mfikes/esprit-board/esprit-board.PDF

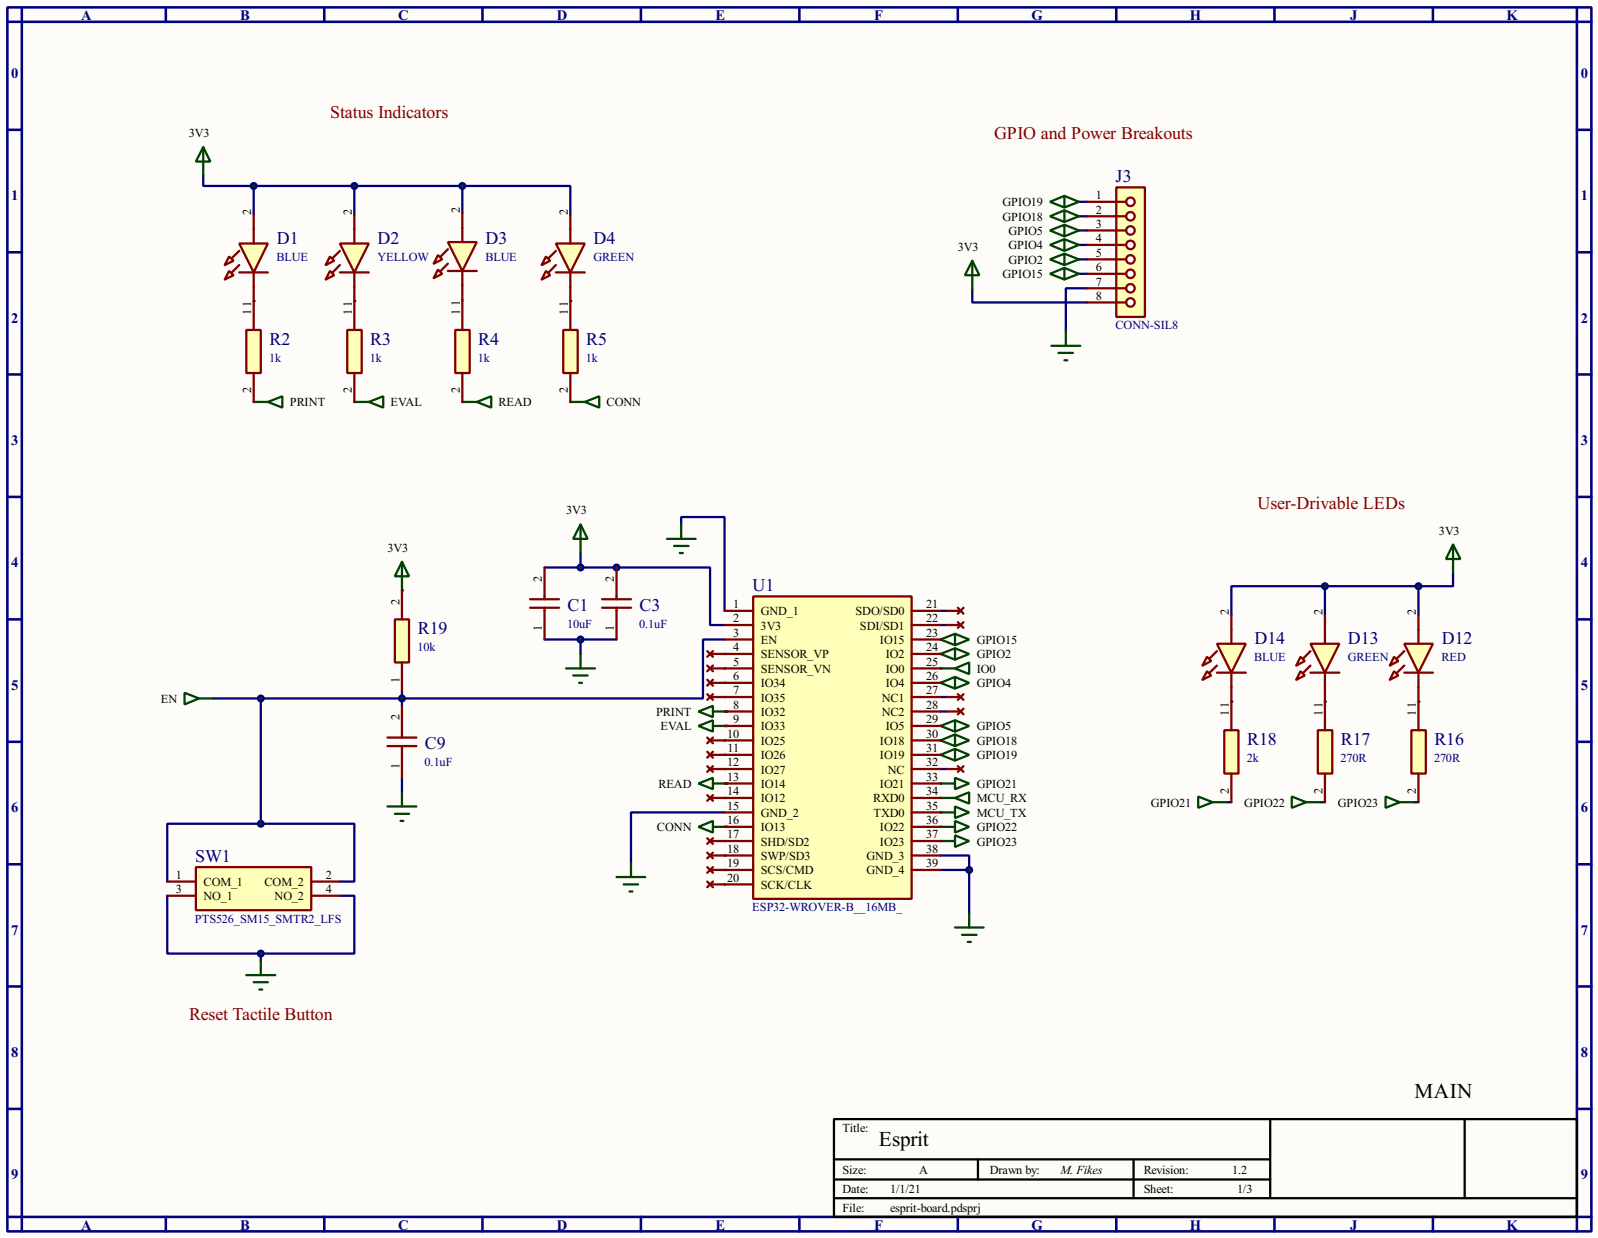
[picture p2: page 1]

GPIO and Power Breakouts Status Indicators

CONN

Esprit

Size: A

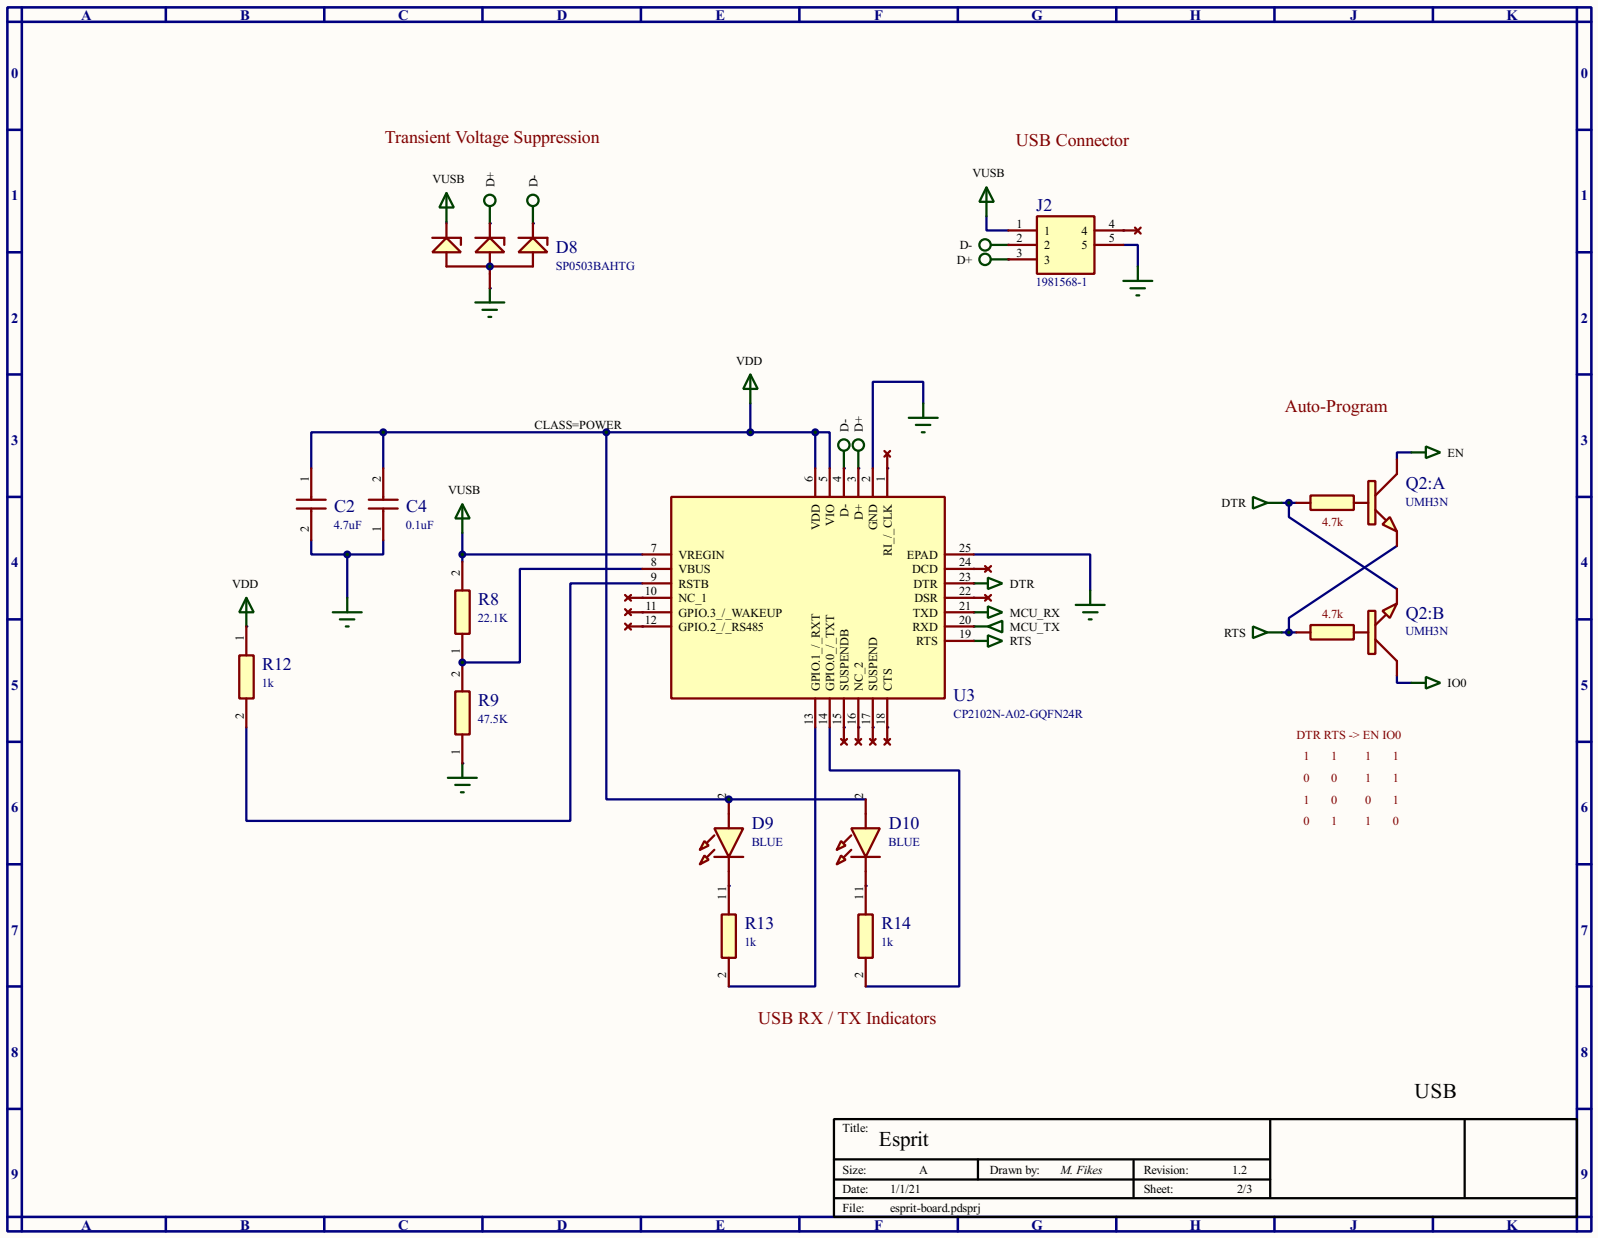
[picture p3: page 2]

BLUE

USB RX / TX Indicators

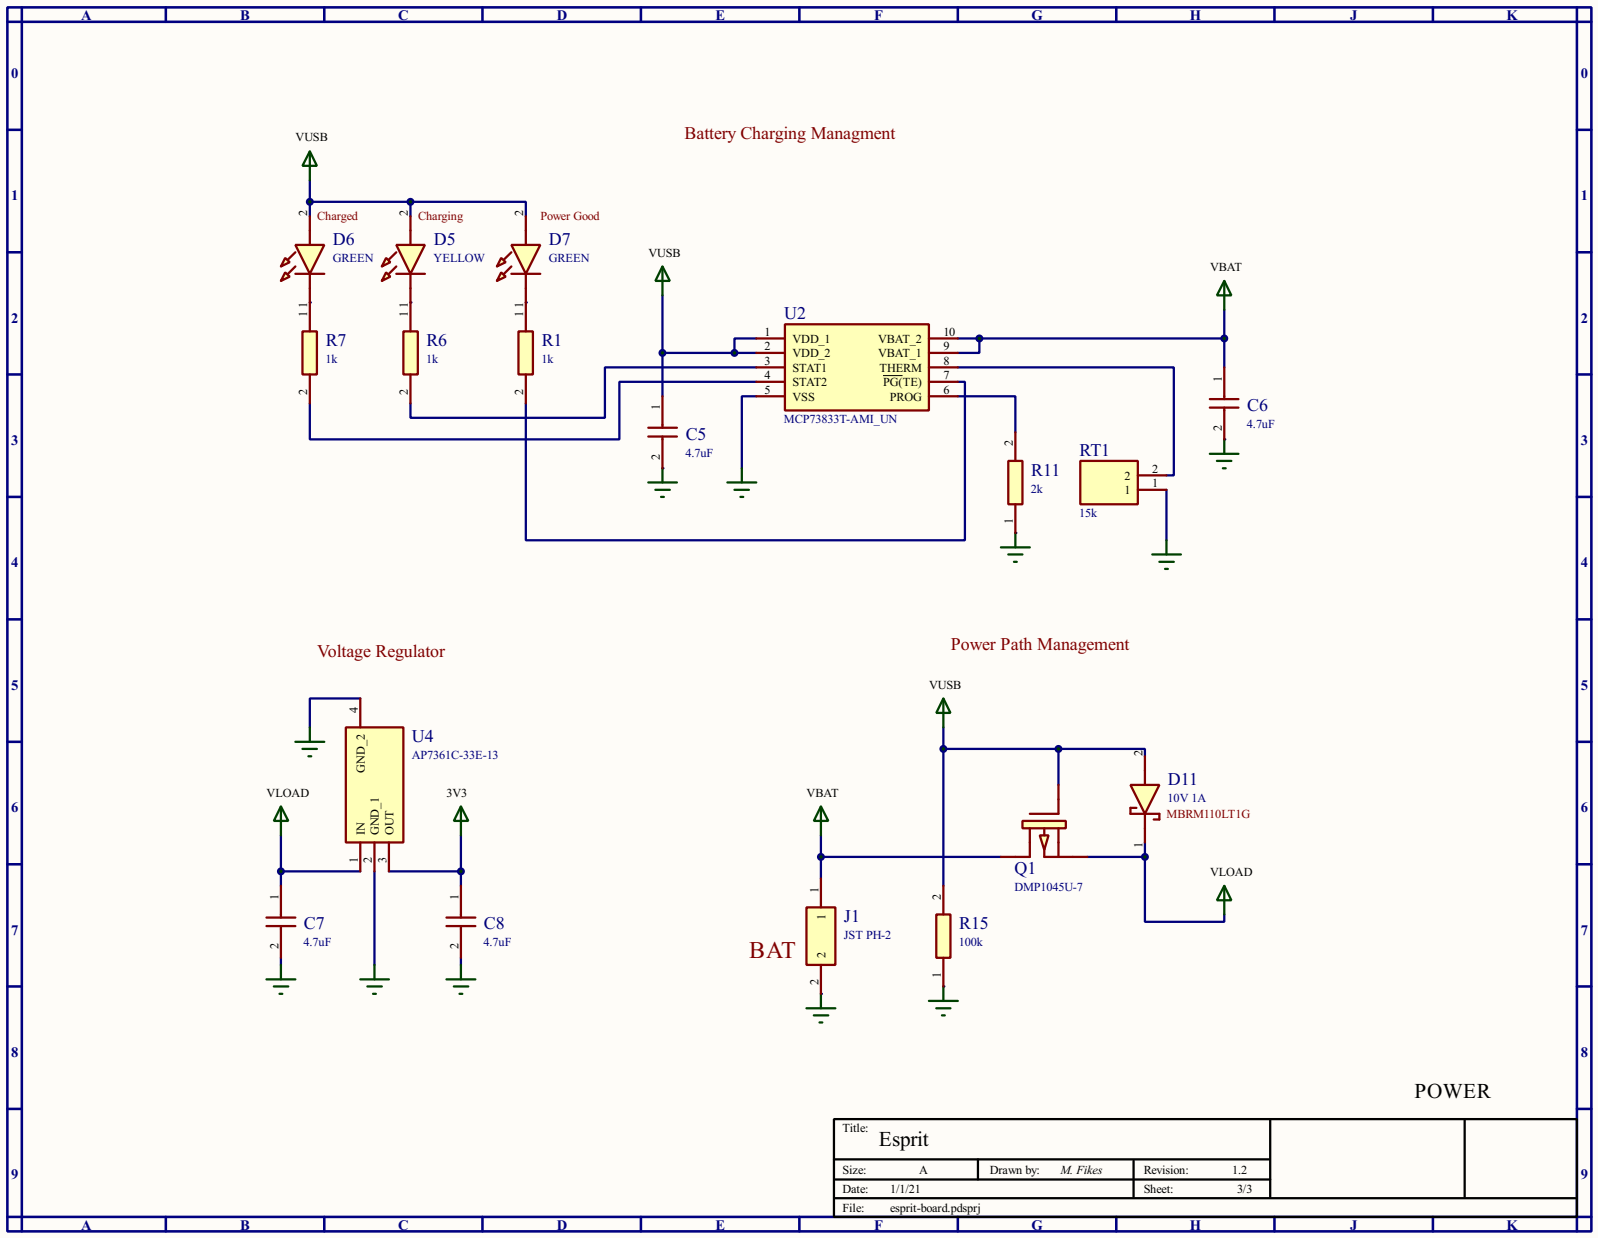
[picture p4: page 3]
