mfikes/esprit-board/(list of files, drawings)

Other design files:
esprit-board.pdsprj
