mfikes/esprit-board/(threads)

Thread 2 (2020-06-11):

Reverse battery polarity protection circuitry

mfikes, 2020-06-11:
If you somehow manage to connect a lipo with reverse polarity, it will smoke the mosfet Q1.

The board could be improved by adding some protection cicuitry for this scenario.

Thread 3 (2020-06-11):

Voltage monitor

mfikes, 2020-06-11:
When the battery is being drained you can reach a point where there is insufficient power to run things (especially, WiFi). The LDO will ultimately stop. What can happen then is that the ESP32 might reboot, and run fine, only to have it reach the point where WiFi is turned on, thus going into a cycle. This cycle can repeat for a while until the battery is sufficiently drained.

An improvement to the board could involve the addition of a voltage monitor to shut things off regardless and avoid the cycling or other undesired behavior if the battery voltage is too low.
