mfikes/esprit-board/(commit log)

2020-05-17 Board rev 1.0
    [esprit-board.pdsprj]
2020-05-19 Board revision 1.1
    [esprit-board.pdsprj]
2020-05-29 Update LEDs and assocaited resistors
    [esprit-board.pdsprj]
2020-05-29 More LED updates and other tweaks
    [esprit-board.pdsprj]
2020-05-31 Rev 1.2
    [Bill Of Materials Esprit.csv, esprit-board.pdsprj]
2020-06-02 Add board rendering
2020-06-11 Add text about thermistor
2020-08-02 Clean up and annotate schematic
    [esprit-board.pdsprj]
2020-08-02 Latest annotations
    [esprit-board.pdsprj]
2020-08-12 Define board-edge DRC allowance room for the JST
    [esprit-board.pdsprj]
2021-01-01 Improved Auto-Program schematic
    [esprit-board.pdsprj]
2021-01-01 Improved symbol for power management switch
    [esprit-board.pdsprj]
2021-01-01 Improved symbols for the TVS diodes
    [esprit-board.pdsprj]
2021-01-01 Clean up voltage regulator schematic
    [esprit-board.pdsprj]
2021-01-01 Fix unconnected wires in schematic
    [esprit-board.pdsprj]
2021-01-01 Remove unused packages
    [esprit-board.pdsprj]
2021-01-01 General schematic cleanup
    [esprit-board.pdsprj]
